Ahad732/Scicalc/Hardware/production/bom.csv

Designator | Footprint | Quantity | Value | LCSC Part #
C1, C10, C11, C2, C3, C4, C5, C6, C7, C8, C9 | 0402 | 11 | 100n
C15, C16 | 0402 | 2 | 15p
C17, C18 | 0402 | 2 | 10u
C19 | 0402 | 1 | 1u
D1, D10, D11, D12, D13, D14, D15, D16, D17, D18, D19, D2, D20, D21, D22, D23, D24, D25, D26, D27, D28, D29, D3, D30, D31, D32, D33, D34, D35, D36, D37, D38, D39, D4, D40, D41, D42, D43, D44, D45, D46, D47, D48, D49, D5, D50, D6, D7, D8, D9 | D_SOD-123 | 50 | 1N4148W
D53 | 0402 | 1 | Red
D54 | 0402 | 1 | Green
J1 | USB_C_Receptacle_HCTL_HC-TYPE-C-16P-01A | 1 | USB_C_Receptacle_USB2.0_16P
J2 | PinHeader_1x02_P2.54mm_Vertical | 1 | Conn_01x02_Pin
J3 | PinSocket_1x09_P2.54mm_Vertical | 1 | Conn_01x09_Pin
L1 | 0603 | 1 | 3.3u
R1, R2 | 0402 | 2 | 27
R10, R5, R8 | 0402 | 3 | 10K
R11 | 0402 | 1 | 604
R3, R4 | 0402 | 2 | 5.1K
R9 | 0402 | 1 | 470
SW1, SW10, SW11, SW12, SW13, SW14, SW15, SW16, SW17, SW18, SW19, SW2, SW20, SW21, SW22, SW23, SW24, SW25, SW26, SW27, SW28, SW29, SW3, SW30, SW31, SW32, SW33, SW34, SW35, SW36, SW37, SW38, SW39, SW4, SW40, SW41, SW42, SW43, SW44, SW45, SW46, SW47, SW48, SW49, SW5, SW50, SW51, SW6, SW7, SW8, SW9 | SW_SPST_TS-1088-xR020 | 51 | SW_Push
U1 | QFN-60-1EP_7x7mm_P0.4mm_EP3.4x3.4mm | 1 | RP2350A
U2 | SOT-23 | 1 | MCP1700x-330xxTT
U3 | WSON-8-1EP_6x5mm_P1.27mm_EP3.4x4.3mm | 1 | W25Q128JVP
U5 | rpi_rmc20452t | 1 | RM2
U6 | VQFN-16-1EP_3x3mm_P0.5mm_EP1.6x1.6mm | 1 | BQ24075RGT
Y1 | Crystal_SMD_3225-4Pin_3.2x2.5mm | 1 | 12 mhz
