Ahad732/Scicalc/3d/scicalc-top-case.step

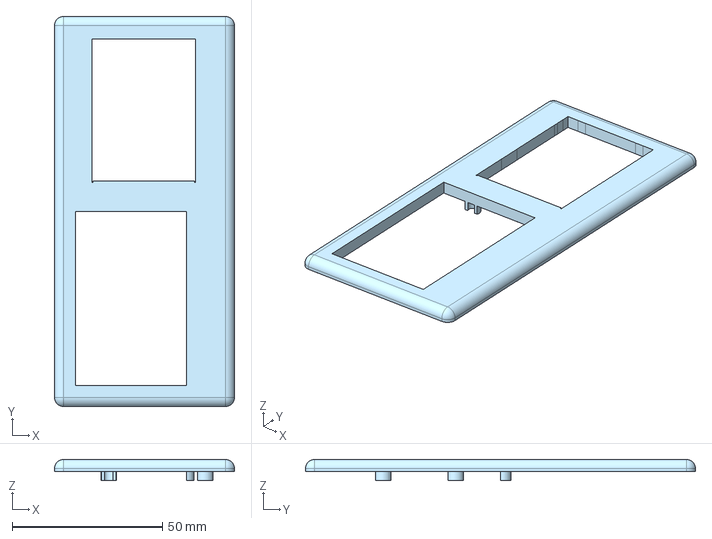
[picture p6: CAD file, 2026-10-25]
3d/scicalc-top-case.step
60.0 x 130.0 x 7.00 mm
