Ahad732/Scicalc/3d/scicalc-bottom-case.step

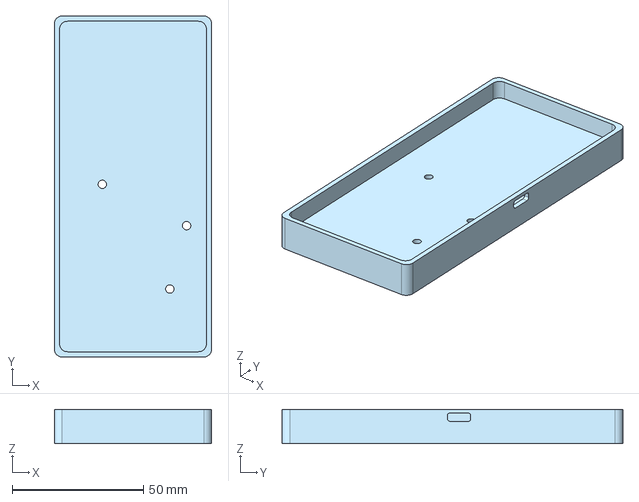
[picture p7: CAD file, 2026-10-25]
3d/scicalc-bottom-case.step
60.0 x 130.0 x 13.0 mm
