Ahad732/Scicalc/3d/button-keycap.step

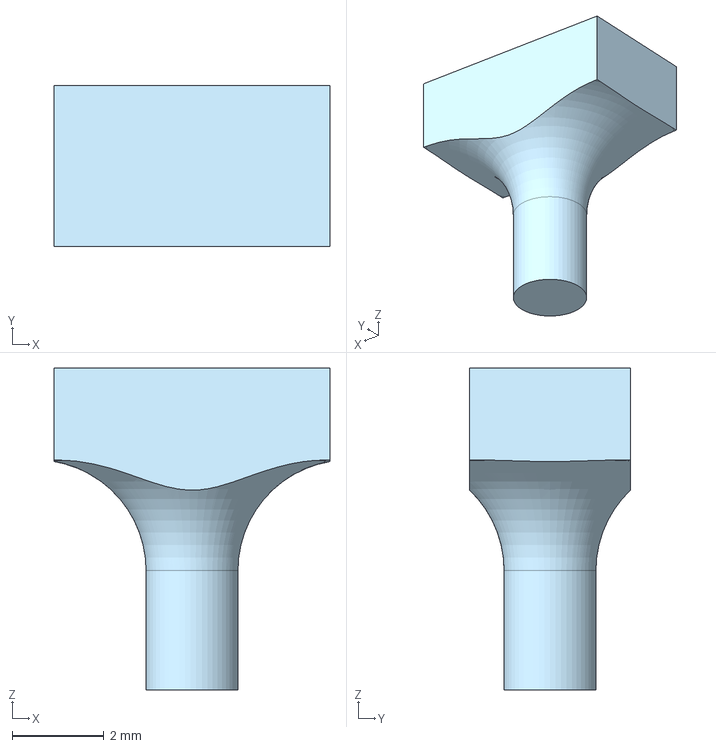
[picture p8: CAD file, 2026-10-25]
3d/button-keycap.step
6.00 x 3.50 x 7.00 mm
