Ahad732/Scicalc/3d/Scicalc-pcb.step

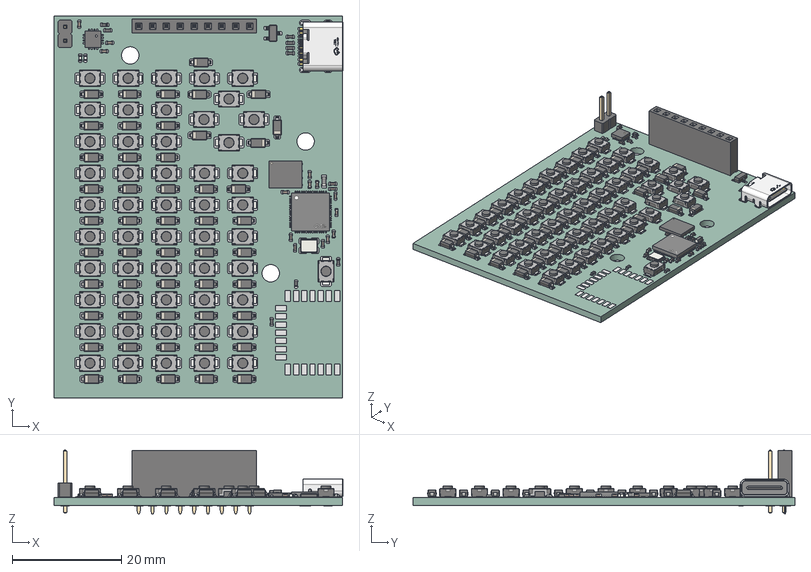
[picture p9: CAD file, 2026-10-25]
3d/Scicalc-pcb.step
52.9 x 70.0 x 11.6 mm
D_SOD-123 x 50
R_0402_1005Metric x 9
SW_SPST_TS-1088-xR020 x 51
C_0402_1005Metric x 16
PinHeader_1x02_P254mm_Vertical
L_0603_1608Metric
SOT-23
WSON-8-1EP_6x5mm_P1.27mm_EP3.4x4.3mm
TQFN_16_1EP_3x3mm_P05mm_EP16x16mm
LED_0402_1005Metric x 2
USB-C-SMD_TYPE-C16PIN
PinSocket_1x09_P2.54mm_Vertical
Crystal_SMD_3225-4Pin_3.2x2.5mm
QFN-60_L7.0-W7.0-P0.40-TL-EP3.4
Scicalc_pad
Scicalc_PCB
