Ahad732/Scicalc/(list of files, cad)

Other CAD files:
3d/Assembly-scicalc.step
3d/scicalc-bottom-case.stl
3d/scicalc-top-case.stl
