Ahad732/Scicalc/media/Scicalc.pdf

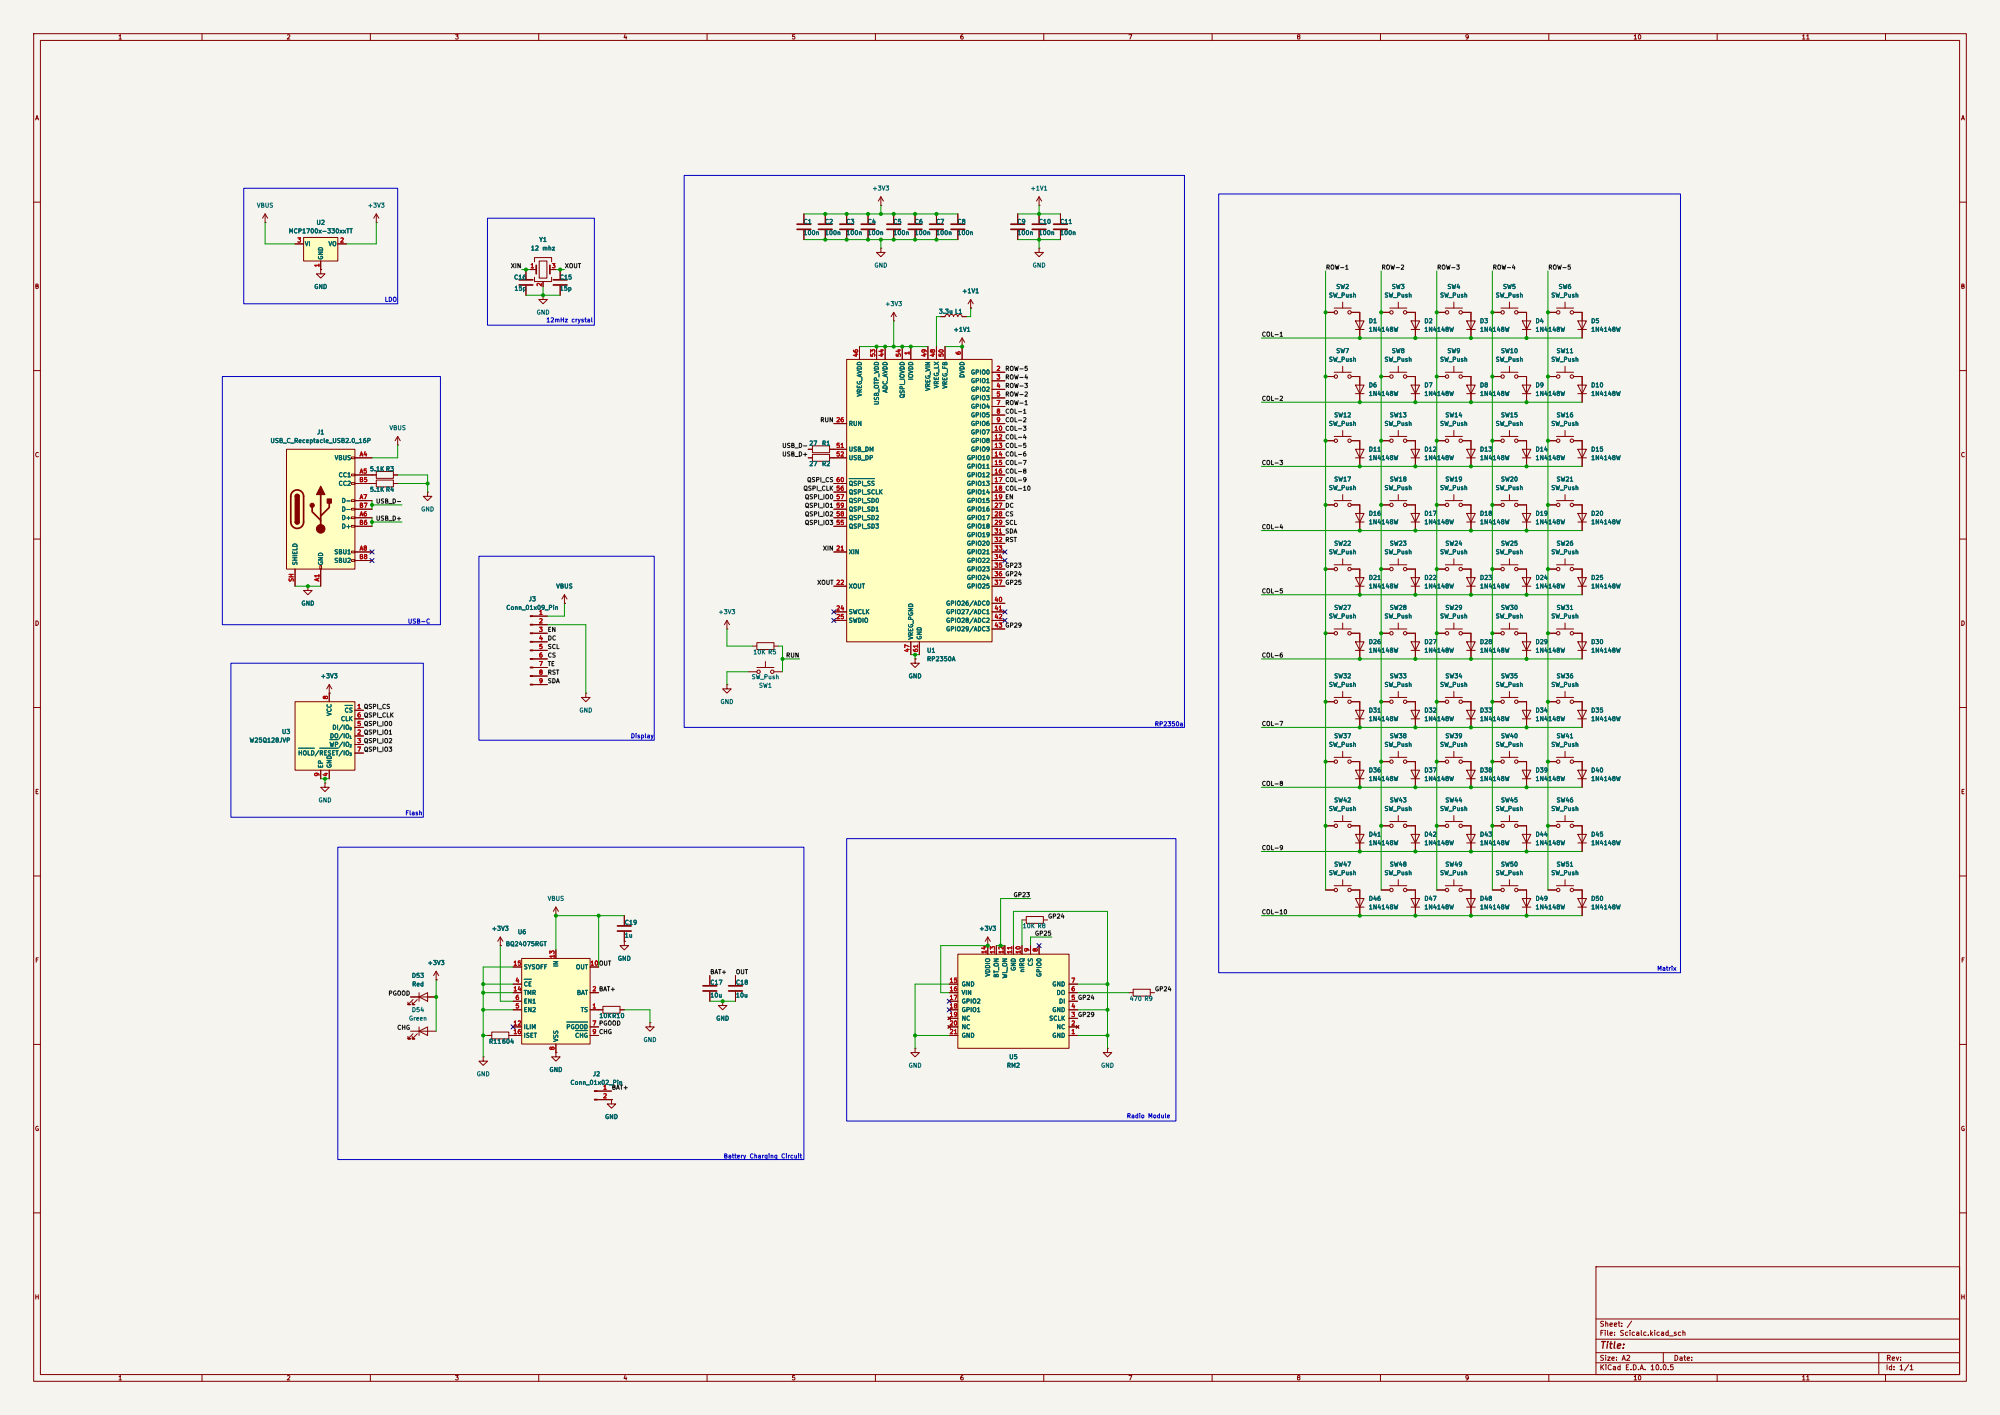
[picture p11: page 1]

4 DI/IO0 5 CLK 6 HOLD/RESET/IO3 7 VCC

9 nIRQ 10 GND 11 WL_ON 12 BT_ON 13 VDDIO 14 GND 15

Size: A2 | Rev:
KiCad E.D.A. 10.0.5 | Id: 1/1
