Ahad732/Scicalc/Hardware/Scicalc.kicad_pcb

## KiCad design Hardware/Scicalc.kicad_pcb (2026-10-25)

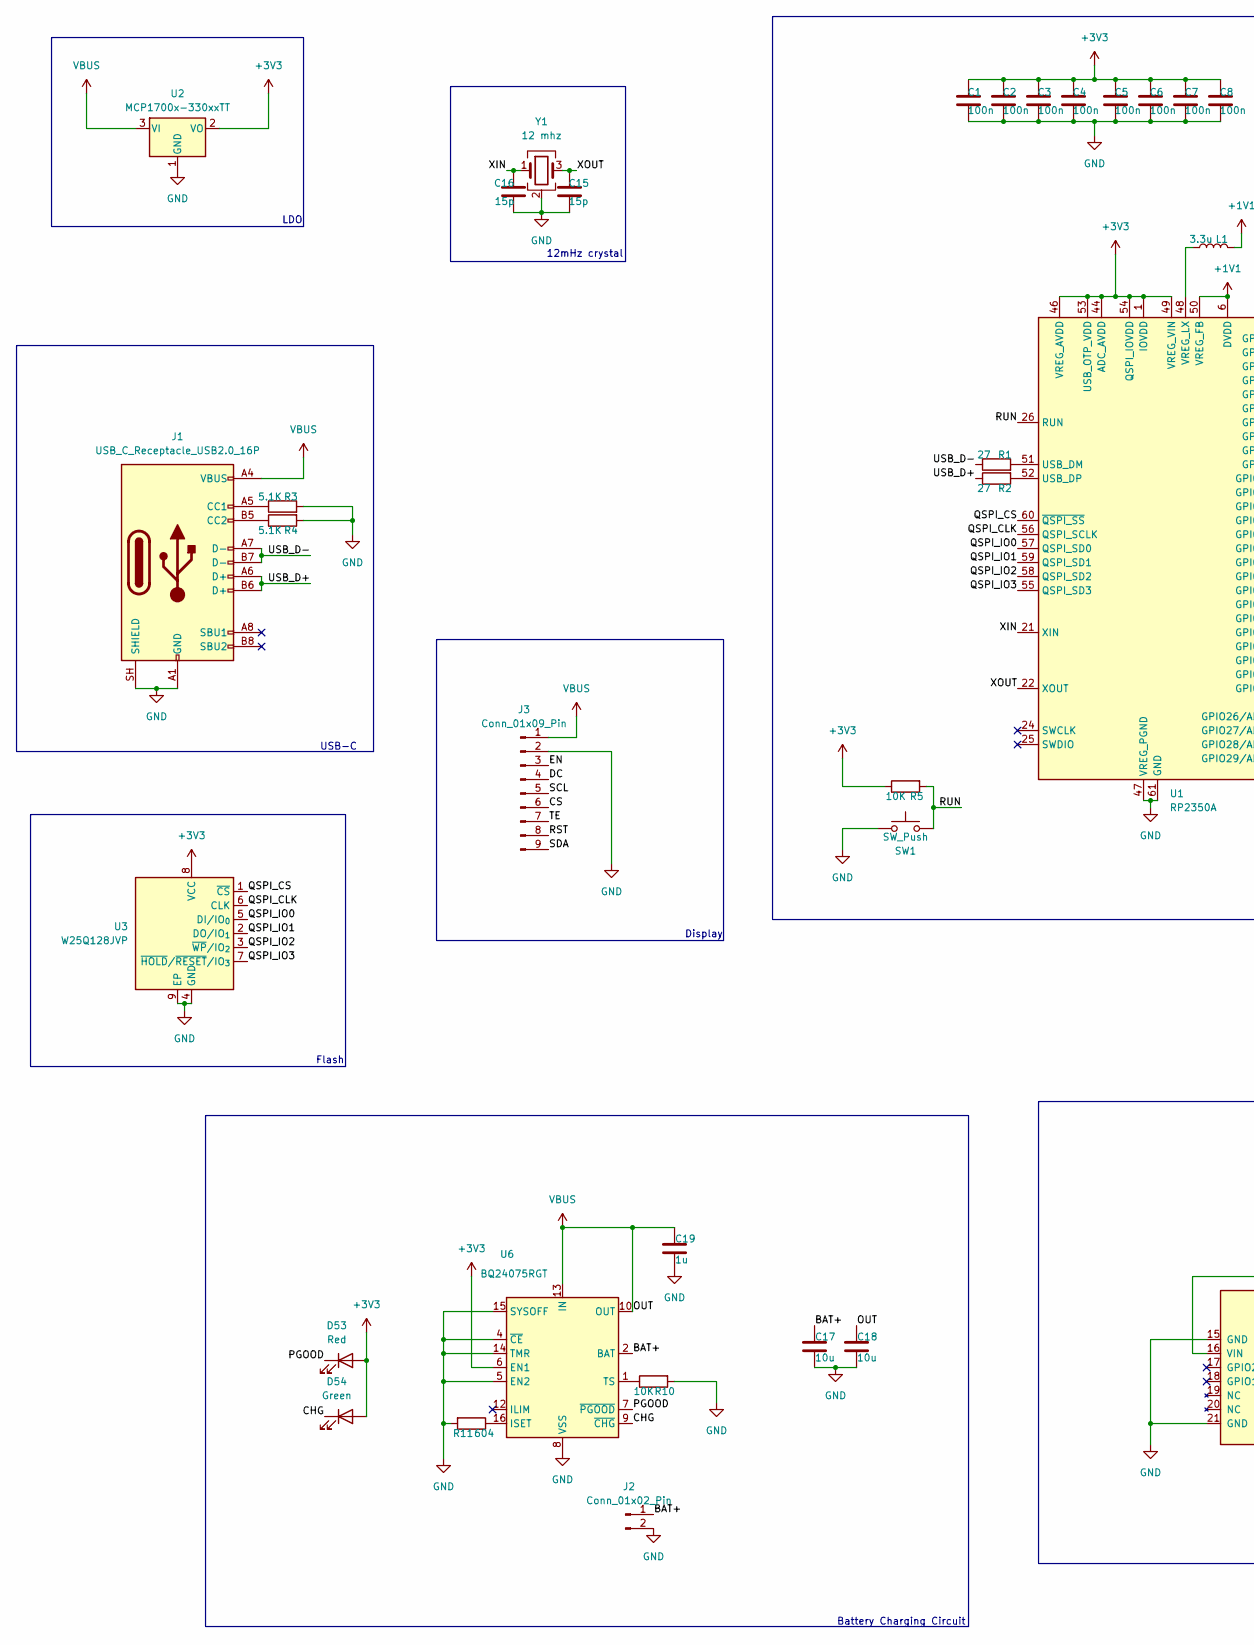
[picture p12: schematic Scicalc.kicad_sch, part in row 1, column 1]

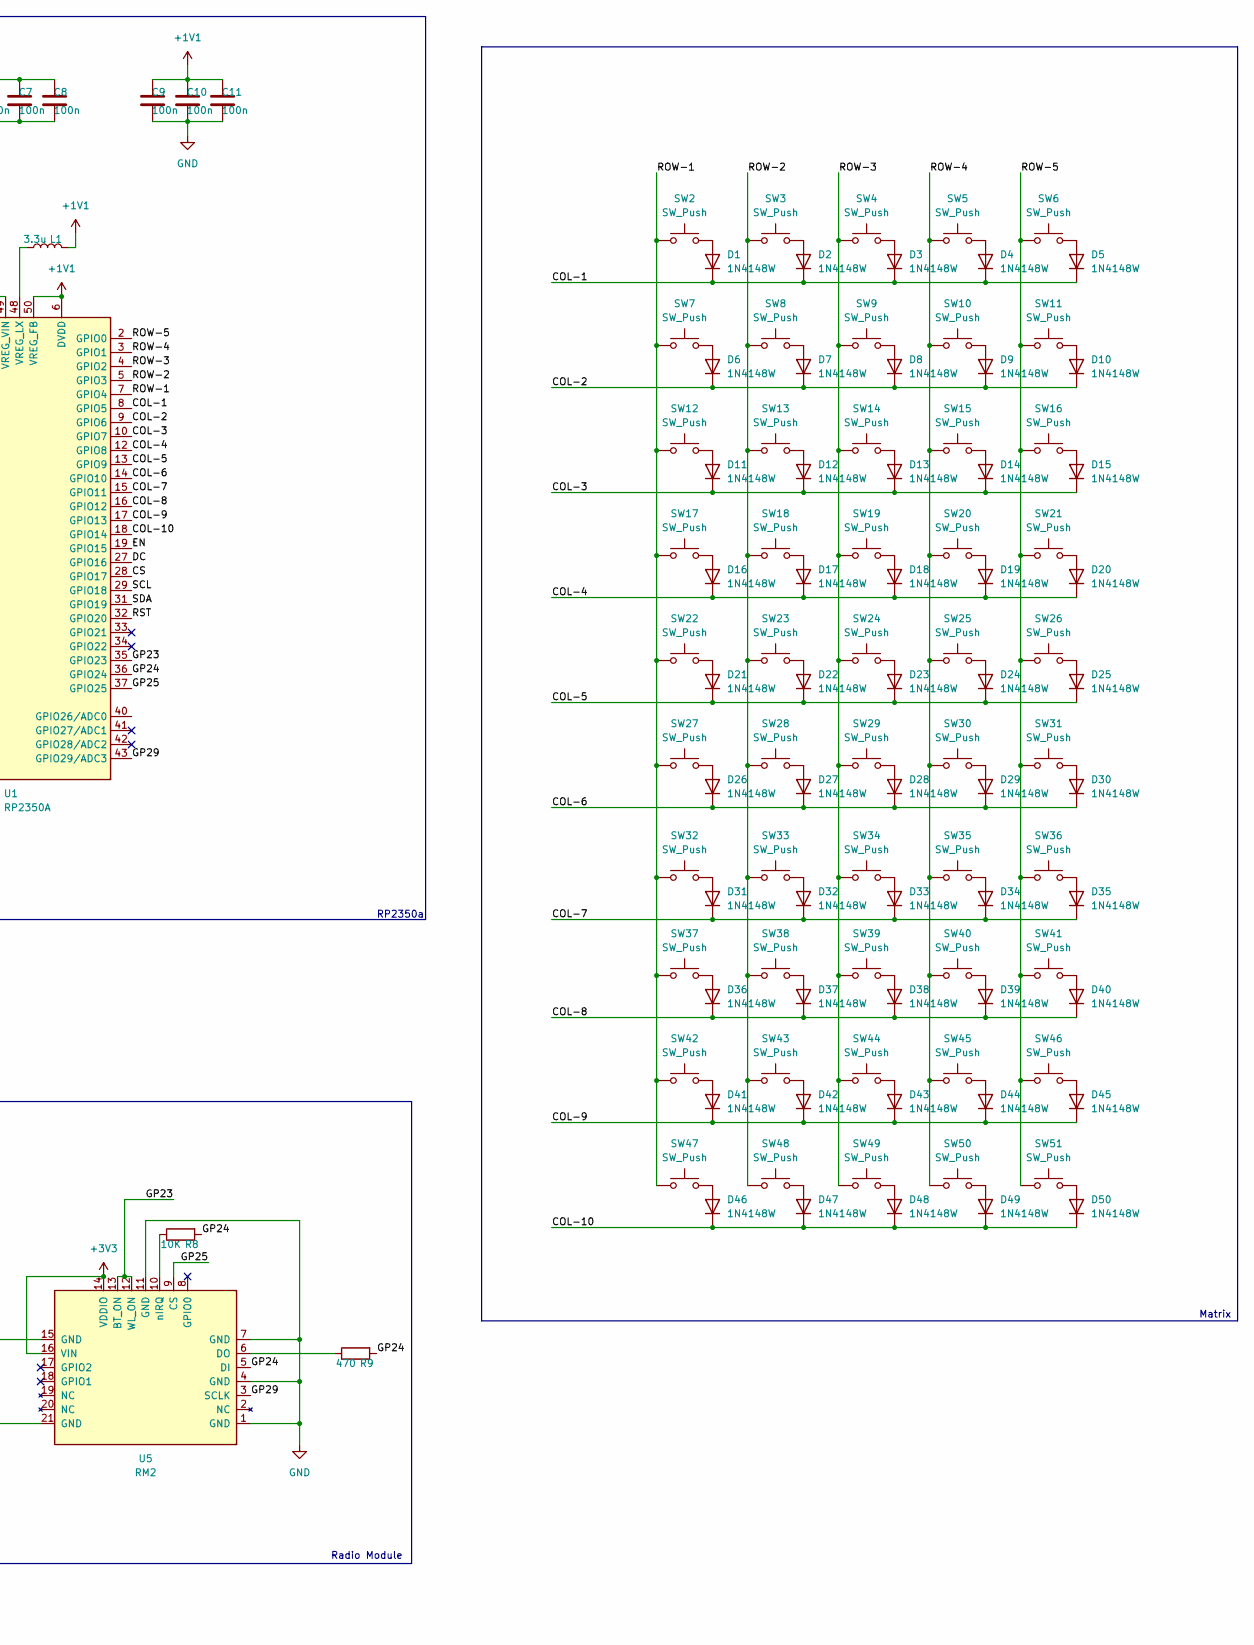
[picture p13: schematic Scicalc.kicad_sch, part in row 1, column 2]

Parts:
C1, C2, C3, C4, C5, C6, C7, C8, C9, C10, C11: 100n; C_0402_1005Metric
C15, C16: 15p; C_0402_1005Metric
C17, C18: 10u; C_0402_1005Metric
C19: 1u; C_0402_1005Metric
D1, D2, D3, D4, D5, D6, D7, D8, D9, D10, D11, D12, D13, D14, D15, D16, D17, D18, D19, D20, D21, D22, D23, D24, D25, D26, D27, D28, D29, D30, D31, D32, D33, D34, D35, D36, D37, D38, D39, D40, D41, D42, D43, D44, D45, D46, D47, D48, D49, D50: 1N4148W; D_SOD-123
D53: Red; LED_0402_1005Metric
D54: Green; LED_0402_1005Metric
J1: USB_C_Receptacle_USB2.0_16P; USB_C_Receptacle_HCTL_HC-TYPE-C-16P-01A
J2: Conn_01x02_Pin; PinHeader_1x02_P2.54mm_Vertical
J3: Conn_01x09_Pin; PinSocket_1x09_P2.54mm_Vertical
L1: 3.3u; L_0805_2012Metric
R1, R2: 27; R_0402_1005Metric
R3, R4: 5.1K; R_0402_1005Metric
R5, R8, R10: 10K; R_0402_1005Metric
R9: 470; R_0402_1005Metric
R11: 604; R_0402_1005Metric
SW1, SW2, SW3, SW4, SW5, SW6, SW7, SW8, SW9, SW10, SW11, SW12, SW13, SW14, SW15, SW16, SW17, SW18, SW19, SW20, SW21, SW22, SW23, SW24, SW25, SW26, SW27, SW28, SW29, SW30, SW31, SW32, SW33, SW34, SW35, SW36, SW37, SW38, SW39, SW40, SW41, SW42, SW43, SW44, SW45, SW46, SW47, SW48, SW49, SW50, SW51: SW_Push; SW_SPST_TS-1088-xR020
U1: RP2350A; QFN-60-1EP_7x7mm_P0.4mm_EP3.4x3.4mm
U2: MCP1700x-330xxTT; SOT-23
U3: W25Q128JVP; WSON-8-1EP_6x5mm_P1.27mm_EP3.4x4.3mm
U5: RM2; rpi_rmc20452t
U6: BQ24075RGT; VQFN-16-1EP_3x3mm_P0.5mm_EP1.6x1.6mm
Y1: 12 mhz; Crystal_SMD_3225-4Pin_3.2x2.5mm

Connections:
+1V1: C9.1, C10.1, C11.1, L1.2, U1.6 (DVDD), U1.23 (DVDD), U1.39 (DVDD), U1.50 (VREG_FB)
+3V3: C1.1, C2.1, C3.1, C4.1, C5.1, C6.1, C7.1, C8.1, D53.2 (A), D54.2 (A), R5.1, U1.1 (IOVDD), U1.11 (IOVDD), U1.20 (IOVDD), U1.30 (IOVDD), U1.38 (IOVDD), U1.44 (ADC_AVDD), U1.45 (IOVDD), U1.46 (VREG_AVDD), U1.49 (VREG_VIN), U1.53 (USB_OTP_VDD), U1.54 (QSPI_IOVDD), U2.2 (VO), U3.8 (VCC), U5.14 (VDDIO), U5.16 (VIN), U6.6 (EN1)
/BAT+: C17.1, J2.1, U6.2 (BAT), U6.3 (BAT)
/CHG: D54.1 (K), U6.9 (~CHG)
/COL-1: D1.1 (K), D2.1 (K), D3.1 (K), D4.1 (K), D5.1 (K), U1.8 (GPIO5)
/COL-2: D6.1 (K), D7.1 (K), D8.1 (K), D9.1 (K), D10.1 (K), U1.9 (GPIO6)
/COL-3: D11.1 (K), D12.1 (K), D13.1 (K), D14.1 (K), D15.1 (K), U1.10 (GPIO7)
/COL-4: D16.1 (K), D17.1 (K), D18.1 (K), D19.1 (K), D20.1 (K), U1.12 (GPIO8)
/COL-5: D21.1 (K), D22.1 (K), D23.1 (K), D24.1 (K), D25.1 (K), U1.13 (GPIO9)
/COL-6: D26.1 (K), D27.1 (K), D28.1 (K), D29.1 (K), D30.1 (K), U1.14 (GPIO10)
/COL-7: D31.1 (K), D32.1 (K), D33.1 (K), D34.1 (K), D35.1 (K), U1.15 (GPIO11)
/COL-8: D36.1 (K), D37.1 (K), D38.1 (K), D39.1 (K), D40.1 (K), U1.16 (GPIO12)
/COL-9: D41.1 (K), D42.1 (K), D43.1 (K), D44.1 (K), D45.1 (K), U1.17 (GPIO13)
/COL-10: D46.1 (K), D47.1 (K), D48.1 (K), D49.1 (K), D50.1 (K), U1.18 (GPIO14)
/CS: J3.6, U1.28 (GPIO17)
/DC: J3.4, U1.27 (GPIO16)
/EN: J3.3, U1.19 (GPIO15)
/GP23: U1.35 (GPIO23), U5.12 (WL_ON), U5.13 (BT_ON)
/GP24: R8.2, R9.2, U1.36 (GPIO24), U5.5 (DI)
/GP25: U1.37 (GPIO25), U5.9 (CS)
/GP29: U1.43 (GPIO29/ADC3), U5.3 (SCLK)
/PGOOD: D53.1 (K), U6.7 (~PGOOD)
/QSPI_CLK: U1.56 (QSPI_SCLK), U3.6 (CLK)
/QSPI_CS: U1.60 (~QSPI_SS), U3.1 (~CS)
/QSPI_IO0: U1.57 (QSPI_SD0), U3.5 (DI/IO_{0})
/QSPI_IO1: U1.59 (QSPI_SD1), U3.2 (DO/IO_{1})
/QSPI_IO2: U1.58 (QSPI_SD2), U3.3 (~WP/IO_{2})
/QSPI_IO3: U1.55 (QSPI_SD3), U3.7 (~HOLD/~RESET/IO_{3})
/ROW-1: SW2.1, SW7.1, SW12.1, SW17.1, SW22.1, SW27.1, SW32.1, SW37.1, SW42.1, SW47.1, U1.7 (GPIO4)
/ROW-2: SW3.1, SW8.1, SW13.1, SW18.1, SW23.1, SW28.1, SW33.1, SW38.1, SW43.1, SW48.1, U1.5 (GPIO3)
/ROW-3: SW4.1, SW9.1, SW14.1, SW19.1, SW24.1, SW29.1, SW34.1, SW39.1, SW44.1, SW49.1, U1.4 (GPIO2)
/ROW-4: SW5.1, SW10.1, SW15.1, SW20.1, SW25.1, SW30.1, SW35.1, SW40.1, SW45.1, SW50.1, U1.3 (GPIO1)
/ROW-5: SW6.1, SW11.1, SW16.1, SW21.1, SW26.1, SW31.1, SW36.1, SW41.1, SW46.1, SW51.1, U1.2 (GPIO0)
/RST: J3.8, U1.32 (GPIO20)
/RUN: R5.2, SW1.2, U1.26 (RUN)
/SCL: J3.5, U1.29 (GPIO18)
/SDA: J3.9, U1.31 (GPIO19)
/TE: J3.7
/USB_D+: J1.A6 (D+), J1.B6 (D+), R2.1
/USB_D-: J1.A7 (D-), J1.B7 (D-), R1.1
/XIN: C16.1, U1.21 (XIN), Y1.1
/XOUT: C15.1, U1.22 (XOUT), Y1.3
GND: C1.2, C2.2, C3.2, C4.2, C5.2, C6.2, C7.2, C8.2, C9.2, C10.2, C11.2, C15.2, C16.2, C17.2, C18.2, C19.2, J1.A1 (GND), J1.A12 (GND), J1.B1 (GND), J1.B12 (GND), J1.SH (SHIELD), J2.2, J3.2, R3.2, R4.2, R10.2, R11.2, SW1.1, U1.47 (VREG_PGND), U1.61 (GND), U2.1 (GND), U3.4 (GND), U3.9 (EP), U5.1 (GND), U5.4 (GND), U5.7 (GND), U5.11 (GND), U5.15 (GND), U5.21 (GND), U6.4 (~CE), U6.5 (EN2), U6.8 (VSS), U6.14 (TMR), U6.15 (SYSOFF), U6.17 (VSS), Y1.2 (G), Y1.4 (G)
unnamed: D1.2 (A), SW2.2
unnamed: D2.2 (A), SW3.2
unnamed: D3.2 (A), SW4.2
unnamed: D4.2 (A), SW5.2
unnamed: D5.2 (A), SW6.2
unnamed: D6.2 (A), SW7.2
unnamed: D7.2 (A), SW8.2
unnamed: D8.2 (A), SW9.2
unnamed: D9.2 (A), SW10.2
unnamed: D10.2 (A), SW11.2
unnamed: D11.2 (A), SW12.2
unnamed: D12.2 (A), SW13.2
unnamed: D13.2 (A), SW14.2
unnamed: D14.2 (A), SW15.2
unnamed: D15.2 (A), SW16.2
unnamed: D16.2 (A), SW17.2
unnamed: D17.2 (A), SW18.2
unnamed: D18.2 (A), SW19.2
unnamed: D19.2 (A), SW20.2
unnamed: D20.2 (A), SW21.2
unnamed: D21.2 (A), SW22.2
unnamed: D22.2 (A), SW23.2
unnamed: D23.2 (A), SW24.2
unnamed: D24.2 (A), SW25.2
unnamed: D25.2 (A), SW26.2
unnamed: D26.2 (A), SW27.2
unnamed: D27.2 (A), SW28.2
unnamed: D28.2 (A), SW29.2
unnamed: D29.2 (A), SW30.2
unnamed: D30.2 (A), SW31.2
unnamed: D31.2 (A), SW32.2
unnamed: D32.2 (A), SW33.2
unnamed: D33.2 (A), SW34.2
unnamed: D34.2 (A), SW35.2
unnamed: D35.2 (A), SW36.2
unnamed: D36.2 (A), SW37.2
unnamed: D37.2 (A), SW38.2
unnamed: D38.2 (A), SW39.2
unnamed: D39.2 (A), SW40.2
unnamed: D40.2 (A), SW41.2
unnamed: D41.2 (A), SW42.2
unnamed: D42.2 (A), SW43.2
unnamed: D43.2 (A), SW44.2
unnamed: D44.2 (A), SW45.2
unnamed: D45.2 (A), SW46.2
unnamed: D46.2 (A), SW47.2
unnamed: D47.2 (A), SW48.2
unnamed: D48.2 (A), SW49.2
unnamed: D49.2 (A), SW50.2
unnamed: D50.2 (A), SW51.2
unnamed: J1.A5 (CC1), R3.1
unnamed: J1.B5 (CC2), R4.1
unnamed: R1.2, U1.51 (USB_DM)
unnamed: R2.2, U1.52 (USB_DP)
unnamed: L1.1, U1.48 (VREG_LX)
unnamed: R9.1, U5.6 (DO)
unnamed: R8.1, U5.10 (nIRQ)
unnamed: R11.1, U6.16 (ISET)
unnamed: R10.1, U6.1 (TS)
VBUS: C18.1, C19.1, J1.A4 (VBUS), J1.A9 (VBUS), J1.B4 (VBUS), J1.B9 (VBUS), J3.1, U2.3 (VI), U6.10 (OUT), U6.11 (OUT), U6.13 (IN)

Notes on the sheet:
Battery Charging Circuit
USB-C
RP2350a
Matrix
Display
Radio Module
12mHz crystal
Flash
LDO

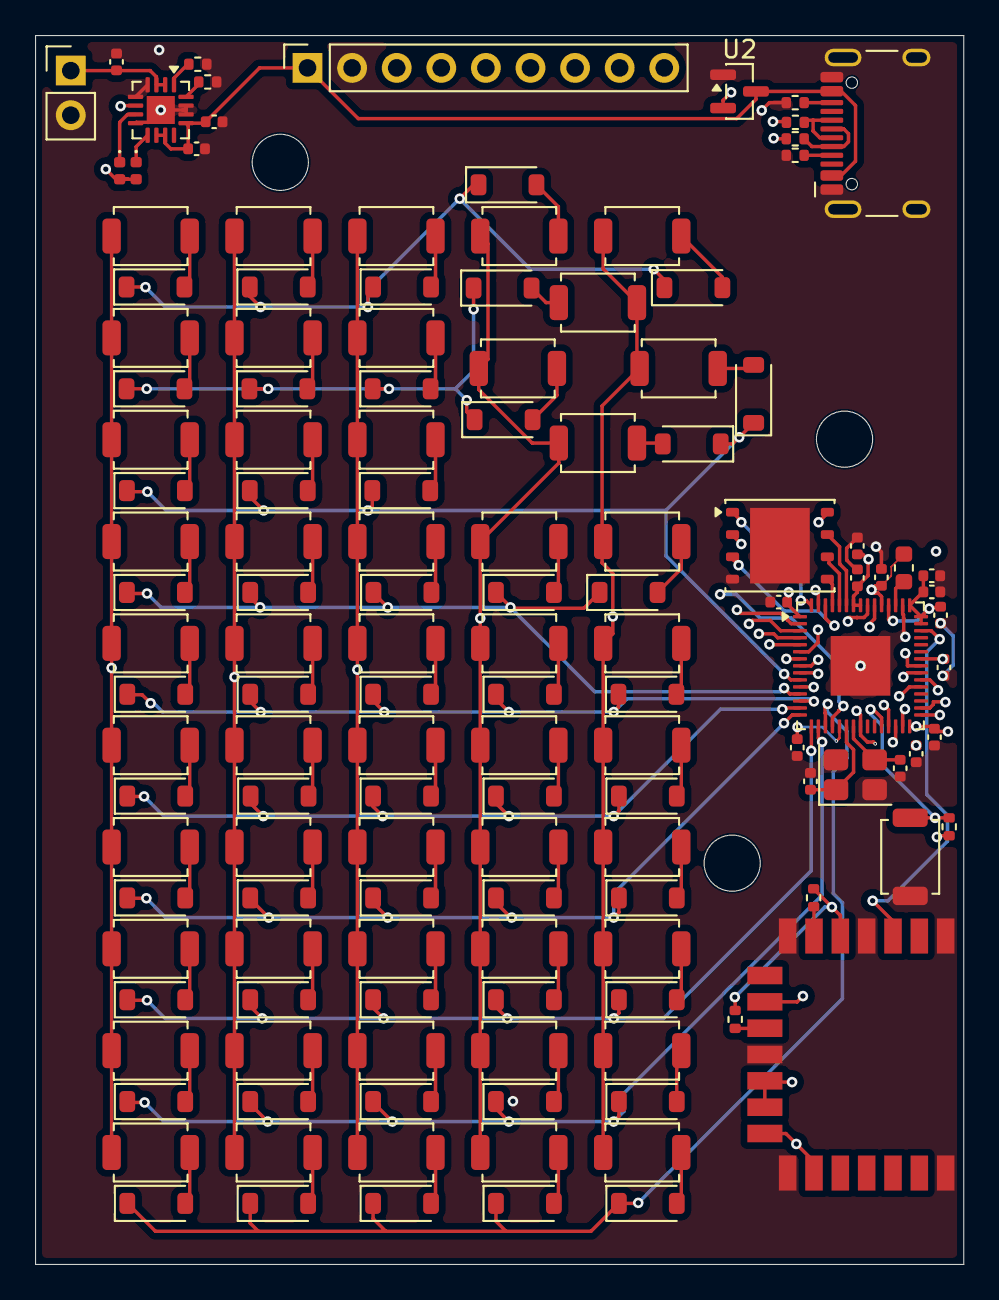
[picture p14: board Scicalc.kicad_pcb from above]

Board: 4 copper layers, 52.9 x 70.0 mm, 138 parts (0 on the bottom side), 102 nets.
