Ahad732/Scicalc/Journal-Ahad.md

# 23 & 24 October 

I started working on the schematic and have been doing it since the last 2 our which was NOT fun and started assigning the footprints for the PCB which i like the most becaunse it requires no research unlike the Schematic. Fast forward to 24th of october when i completed the PCB which involved me losing wor 3 times in a row as kicad kept crashing

Schematic: 

PCB: 

# 24 October 2025

I started working on the BOM and found out that the battery output wasnt even connected to anything and had to redo that and also made the BOM which was not a much timetakiing part as it was simple. We will be using a 2500 Mah battery for long life and loger use time
