Ahad732/Scicalc/(commit log)

2026-10-21 Updated PCB
    [Scicalc.kicad_pcb, Scicalc.kicad_sch]
2026-10-24 Completed PCB
    [BOM.csv, Scicalc.kicad_pcb, Scicalc.kicad_sch, bom.csv, designators.csv, positions.csv]
2026-10-25 added BOM to readme
2026-10-25 Added images to readme
    [Scicalc.kicad_sch]
2026-10-25 added latest images, updated readme, gitignore
    [4311 2in TFT IPS Display.step, Assembly-scicalc.step, Scicalc-pcb.step, Scicalc.kicad_pcb, button-keycap.step, designators.csv, scicalc-bottom-case.step, scicalc-bottom-case.stl]
